gabeak2/RIAA_PREAMP/RIAA_preamp.kicad_pcb

## KiCad design RIAA_preamp.kicad_pcb (2025-05-13)

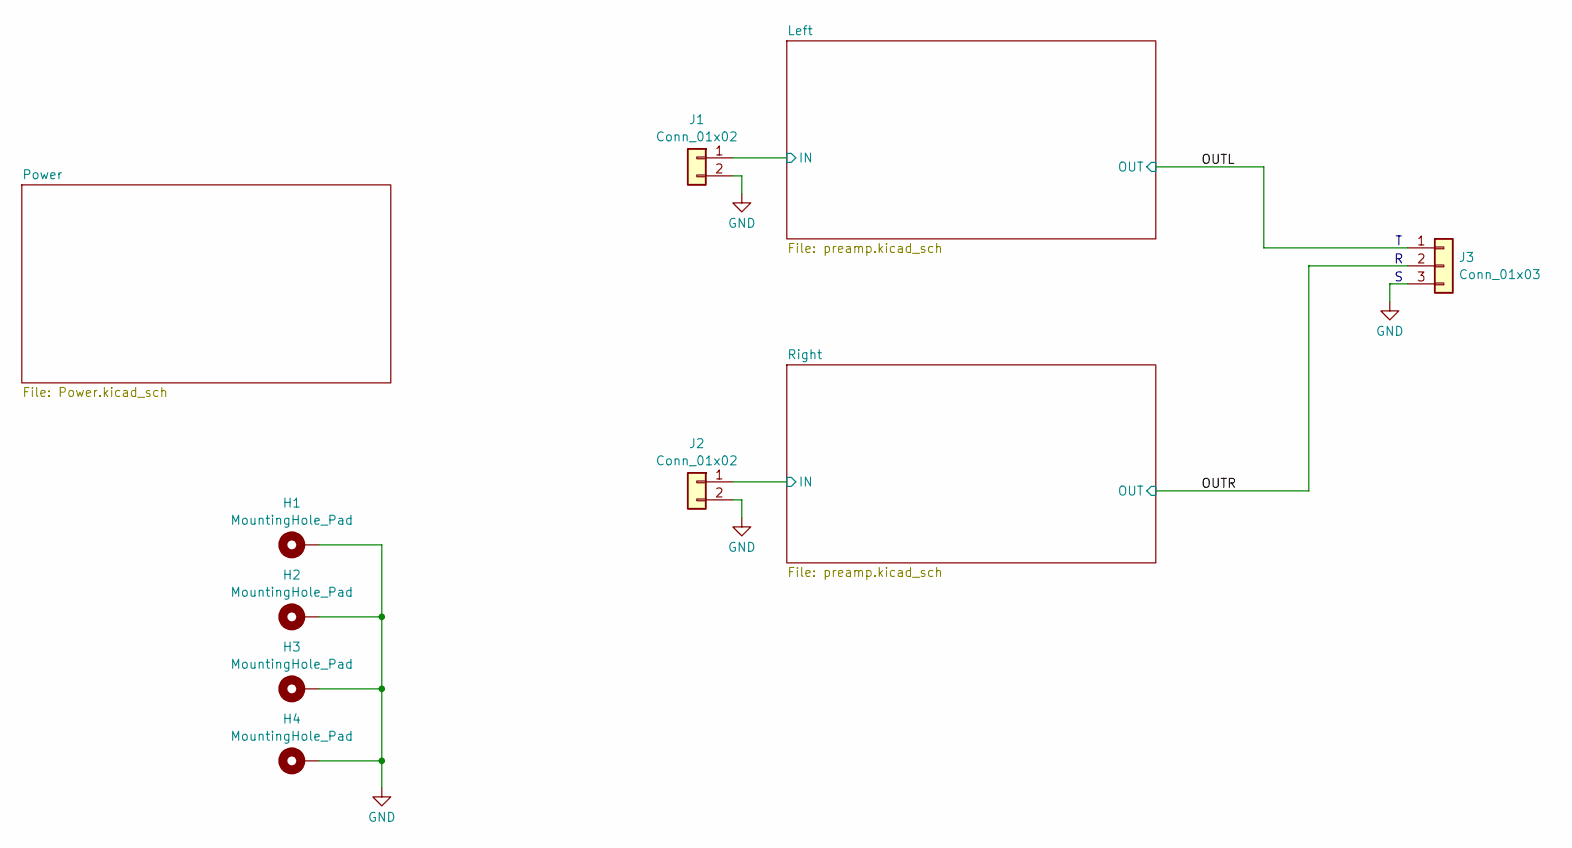
[picture p1: schematic RIAA_preamp.kicad_sch]

Parts:
H1, H2, H3, H4: MountingHole_Pad; MountingHole_3.2mm_M3_DIN965_Pad
J1, J2: Conn_01x02; PinHeader_1x02_P2.54mm_Vertical
J3: Conn_01x03; PinHeader_1x03_P2.54mm_Vertical

Connections:
/Left/IN: J1.1; also elsewhere on the board
/OUTL: J3.1; also elsewhere on the board
/OUTR: J3.2; also elsewhere on the board
/Right/IN: J2.1; also elsewhere on the board
GND: H1.1, H2.1, H3.1, H4.1, J1.2, J2.2, J3.3; also elsewhere on the board

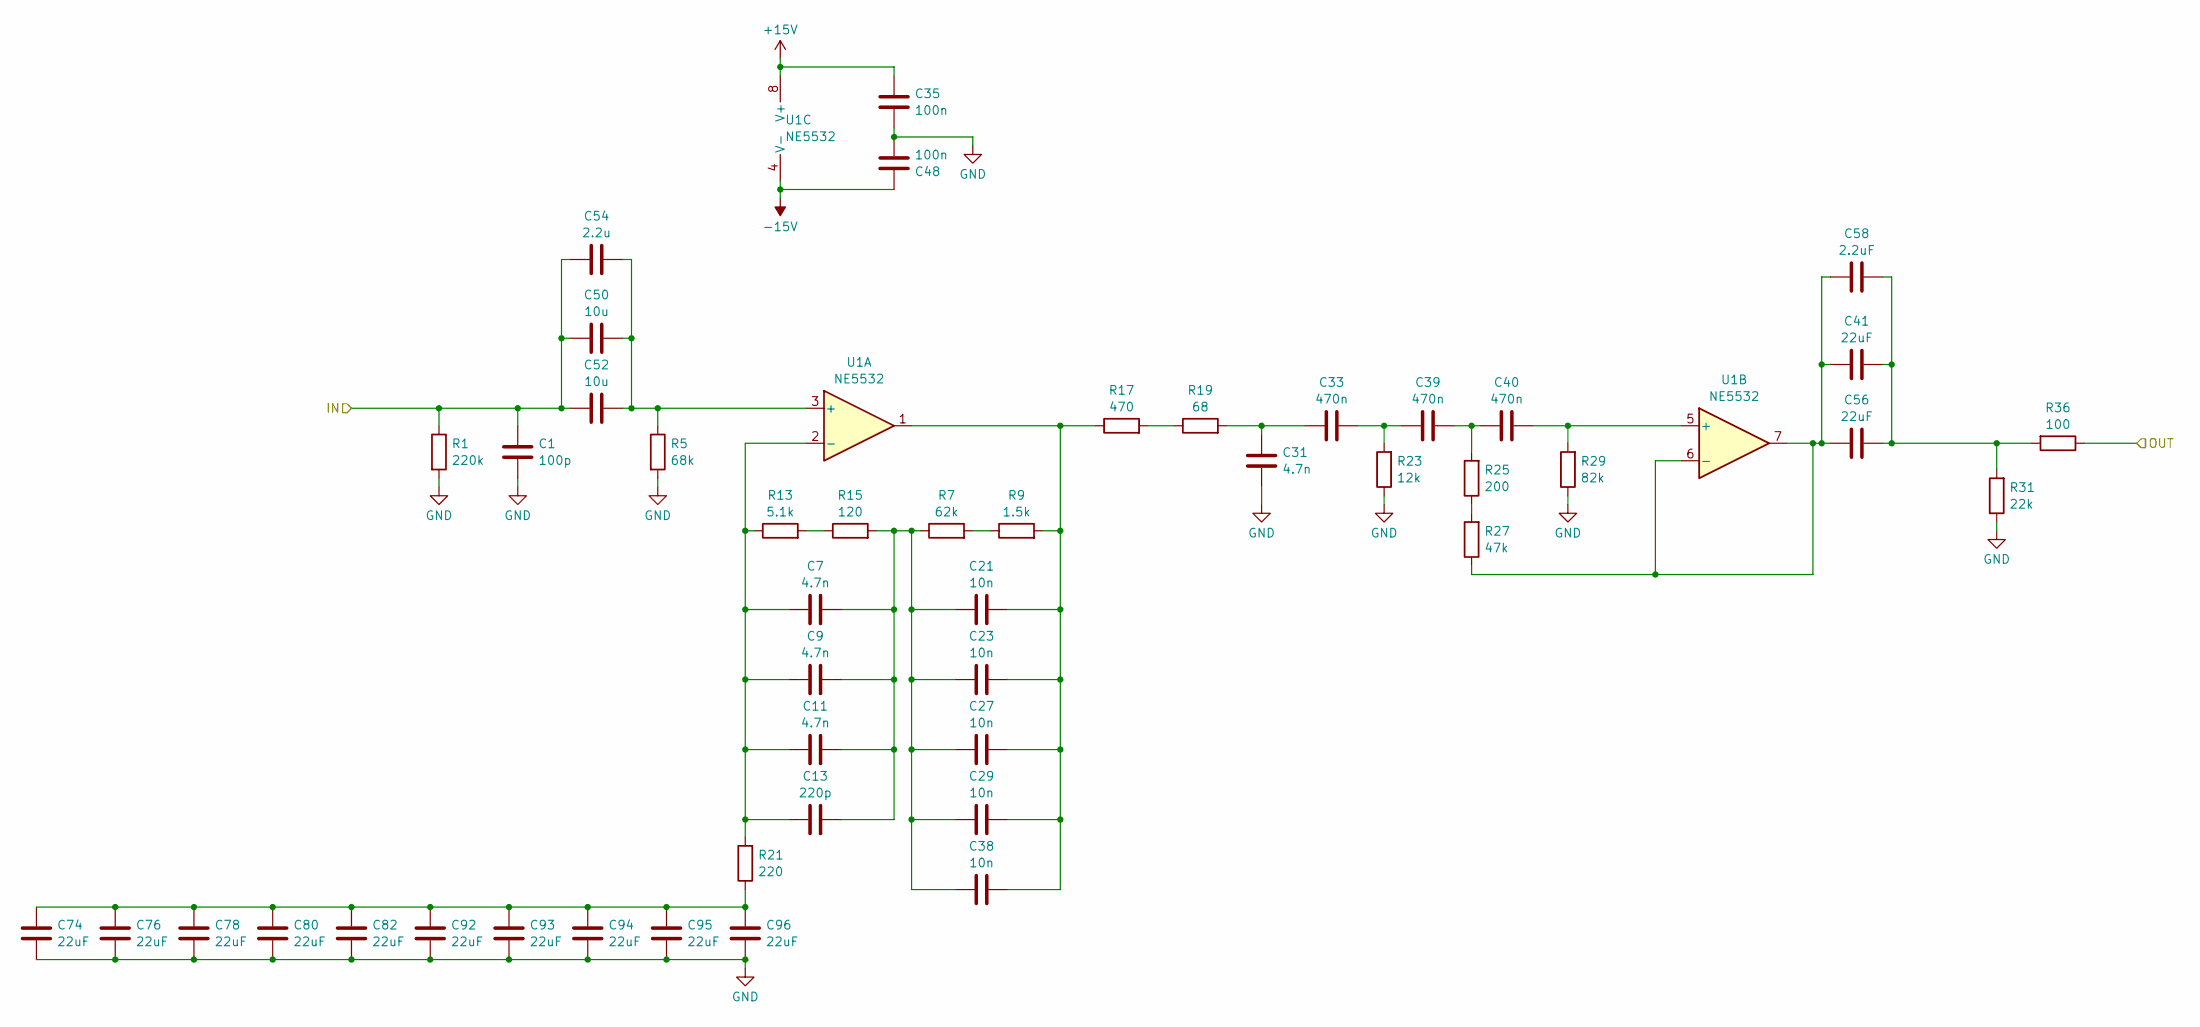
[picture p2: schematic preamp.kicad_sch]

Parts:
C1: 100p; C_0603_1608Metric; LCSC C55722
C7, C9, C11, C31: 4.7n; C_0603_1608Metric; LCSC C883564
C13: 220p; C_0603_1608Metric; LCSC C519500
C21, C23, C27, C29, C38: 10n; C_0805_2012Metric; LCSC C441760
C33, C39, C40: 470n; C_0805_2012Metric; LCSC C13967
C35, C48: 100n; C_0603_1608Metric; LCSC C14663
C41, C56: 22uF; C_0805_2012Metric; LCSC C45783
C50, C52: 10u; C_0805_2012Metric; LCSC C440198
C54: 2.2u; C_0805_2012Metric; LCSC C377773
C58: 2.2uF; C_0805_2012Metric; LCSC C377773
C74, C76, C78, C80, C82, C92, C93, C94, C95, C96: 22uF; C_0603_1608Metric; LCSC C59461
R1: 220k; R_0603_1608Metric; LCSC C22961
R5: 68k; R_0603_1608Metric; LCSC C23231
R7: 62k; R_0603_1608Metric; LCSC C23221
R9: 1.5k; R_0603_1608Metric; LCSC C22843
R13: 5.1k; R_0603_1608Metric; LCSC C23186
R15: 120; R_0603_1608Metric; LCSC C22787
R17: 470; R_0603_1608Metric; LCSC C23179
R19: 68; R_0603_1608Metric; LCSC C27592
R21: 220; R_0603_1608Metric; LCSC C22962
R23: 12k; R_0603_1608Metric; LCSC C22790
R25: 200; R_0603_1608Metric; LCSC C8218
R27: 47k; R_0603_1608Metric; LCSC C25819
R29: 82k; R_0603_1608Metric; LCSC C23254
R31: 22k; R_0603_1608Metric; LCSC C31850
R36: 100; R_0603_1608Metric; LCSC C22775
U1: NE5532; SOIC-8_3.9x4.9mm_P1.27mm; LCSC C7426

Connections:
+15V: C35.2, U1.8 (V+); also elsewhere on the board
-15V: C48.2, U1.4 (V-); also elsewhere on the board
/Left/IN: C1.1, C50.1, C52.1, C54.1, R1.1; also elsewhere on the board
/OUTL: R36.1; also elsewhere on the board
GND: C1.2, C31.1, C35.1, C48.1, C74.2, C76.2, C78.2, C80.2, C82.2, C92.2, C93.2, C94.2, C95.2, C96.2, R1.2, R5.2, R23.1, R29.1, R31.1; also elsewhere on the board
unnamed: C7.2, C9.2, C11.2, C13.2, C21.1, C23.1, C27.1, C29.1, C38.1, R7.1, R15.2
unnamed: C21.2, C23.2, C27.2, C29.2, C38.2, R9.2, R17.1, U1.1
unnamed: C31.2, C33.2, R19.2
unnamed: C33.1, C39.2, R23.2
unnamed: C39.1, C40.2, R25.2
unnamed: C41.1, C56.1, C58.1, R31.2, R36.2
unnamed: C74.1, C76.1, C78.1, C80.1, C82.1, C92.1, C93.1, C94.1, C95.1, C96.1, R21.1
unnamed: R7.2, R9.1
unnamed: R13.2, R15.1
unnamed: R17.2, R19.1
unnamed: R25.1, R27.2
unnamed: C50.2, C52.2, C54.2, R5.1, U1.3 (+)
unnamed: C7.1, C9.1, C11.1, C13.1, R13.1, R21.2, U1.2 (-)
unnamed: C40.1, R29.2, U1.5 (+)
unnamed: C41.2, C56.2, C58.2, R27.1, U1.6 (-), U1.7

Parts of its further copies:
C5: 100p; C_0603_1608Metric; LCSC C55722
C6, C8, C10, C22: 4.7n; C_0603_1608Metric; LCSC C883564
C12: 220p; C_0603_1608Metric; LCSC C519500
C17, C18, C19, C20, C36: 10n; C_0805_2012Metric; LCSC C441760
C24, C28, C30: 470n; C_0805_2012Metric; LCSC C13967
C32, C55: 22uF; C_0805_2012Metric; LCSC C45783
C34, C59: 100n; C_0603_1608Metric; LCSC C14663
C49, C51: 10u; C_0805_2012Metric; LCSC C440198
C53: 2.2u; C_0805_2012Metric; LCSC C377773
C57: 2.2uF; C_0805_2012Metric; LCSC C377773
C73, C75, C77, C79, C81, C87, C88, C89, C90, C91: 22uF; C_0603_1608Metric; LCSC C59461
R3: 220k; R_0603_1608Metric; LCSC C22961
R4: 68k; R_0603_1608Metric; LCSC C23231
R6: 62k; R_0603_1608Metric; LCSC C23221
R8: 1.5k; R_0603_1608Metric; LCSC C22843
R11: 5.1k; R_0603_1608Metric; LCSC C23186
R12: 120; R_0603_1608Metric; LCSC C22787
R14: 470; R_0603_1608Metric; LCSC C23179
R16: 68; R_0603_1608Metric; LCSC C27592
R18: 12k; R_0603_1608Metric; LCSC C22790
R20: 220; R_0603_1608Metric; LCSC C22962
R22: 200; R_0603_1608Metric; LCSC C8218
R24: 47k; R_0603_1608Metric; LCSC C25819
R26: 82k; R_0603_1608Metric; LCSC C23254
R28: 22k; R_0603_1608Metric; LCSC C31850
R30: 100; R_0603_1608Metric; LCSC C22775
U5: NE5532; SOIC-8_3.9x4.9mm_P1.27mm; LCSC C7426

Connections of its further copies:
+15V: C34.2, U5.8 (V+); also elsewhere on the board
-15V: C59.2, U5.4 (V-); also elsewhere on the board
/OUTR: R30.1; also elsewhere on the board
/Right/IN: C5.1, C49.1, C51.1, C53.1, R3.1; also elsewhere on the board
GND: C5.2, C22.1, C34.1, C59.1, C73.2, C75.2, C77.2, C79.2, C81.2, C87.2, C88.2, C89.2, C90.2, C91.2, R3.2, R4.2, R18.1, R26.1, R28.1; also elsewhere on the board
unnamed: C6.2, C8.2, C10.2, C12.2, C17.1, C18.1, C19.1, C20.1, C36.1, R6.1, R12.2
unnamed: C17.2, C18.2, C19.2, C20.2, C36.2, R8.2, R14.1, U5.1
unnamed: C22.2, C24.2, R16.2
unnamed: C24.1, C28.2, R18.2
unnamed: C28.1, C30.2, R22.2
unnamed: C32.1, C55.1, C57.1, R28.2, R30.2
unnamed: C73.1, C75.1, C77.1, C79.1, C81.1, C87.1, C88.1, C89.1, C90.1, C91.1, R20.1
unnamed: R6.2, R8.1
unnamed: R11.2, R12.1
unnamed: R14.2, R16.1
unnamed: R22.1, R24.2
unnamed: C49.2, C51.2, C53.2, R4.1, U5.3 (+)
unnamed: C6.1, C8.1, C10.1, C12.1, R11.1, R20.2, U5.2 (-)
unnamed: C30.1, R26.2, U5.5 (+)
unnamed: C32.2, C55.2, C57.2, R24.1, U5.6 (-), U5.7

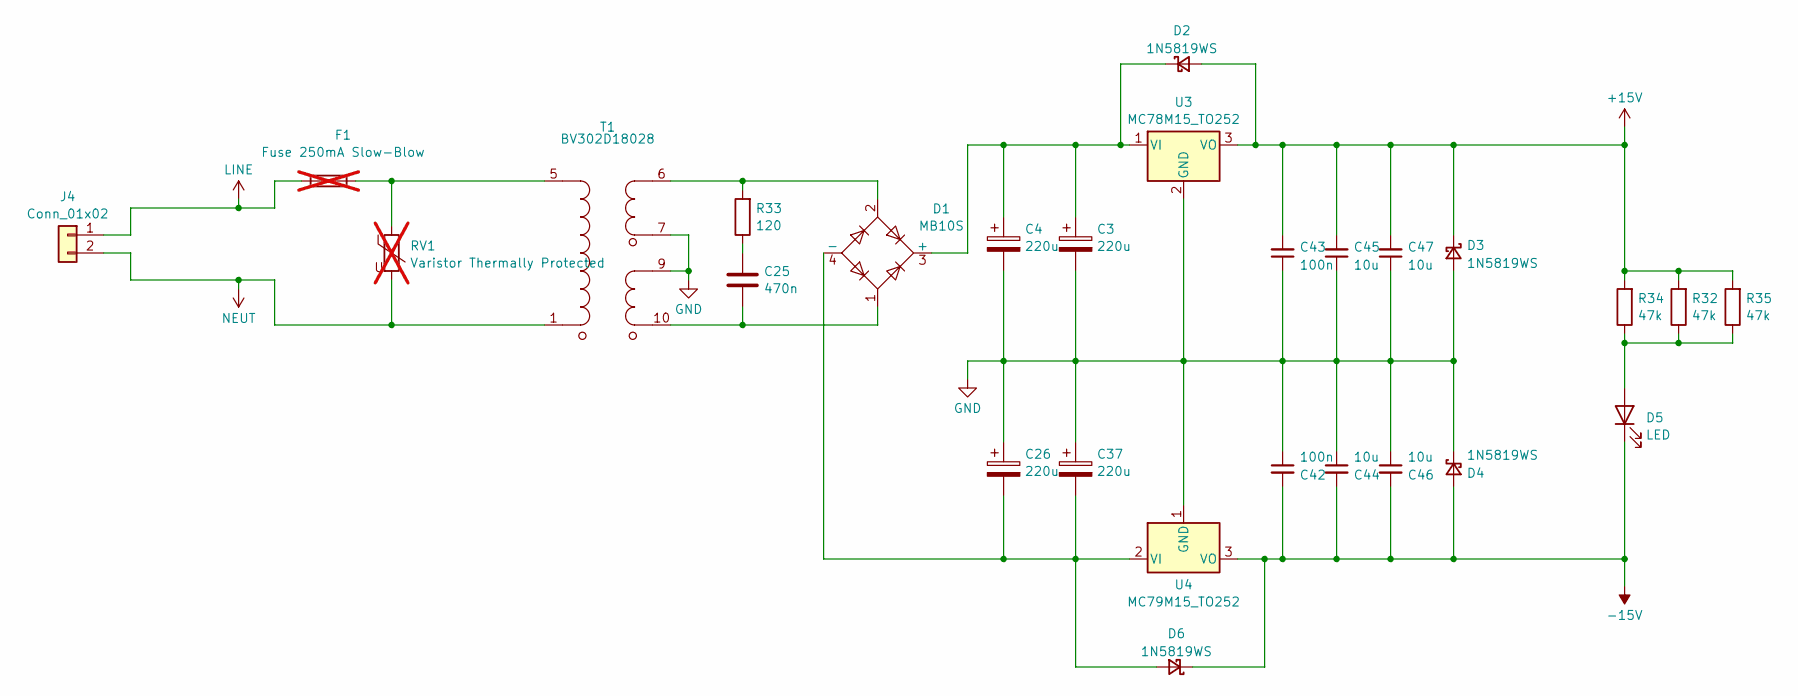
[picture p3: schematic Power.kicad_sch]

Parts:
C3, C4, C26, C37: 220u; CP_Elec_8x10.5; LCSC C2162304
C25: 470n; C_0805_2012Metric; LCSC C13967
C42, C43: 100n; C_0805_2012Metric; LCSC C14663
C44, C45, C46, C47: 10u; C_0805_2012Metric; LCSC C440198
D1: MB10S; TO-269AA; LCSC C2488
D2, D3, D4, D6: 1N5819WS; D_SOD-323; LCSC C191023
D5: LED; LED_D5.0mm
F1: Fuse 250mA Slow-Blow; Fuse_BelFuse_0ZRE0008FF_L8.3mm_W3.8mm; not fitted
J4: Conn_01x02; SolderWire-1sqmm_1x02_P5.4mm_D1.4mm_OD2.7mm_Relief
R32, R34, R35: 47k; R_0603_1608Metric; LCSC C25819
R33: 120; R_0603_1608Metric; LCSC C22787
RV1: Varistor Thermally Protected; RV_Disc_D12mm_W3.9mm_P7.5mm; not fitted
T1: BV302D18028
U3: MC78M15_TO252; TO-252-2; LCSC C95992
U4: MC79M15_TO252; TO-252-2; LCSC C19626424

Connections:
+15V: C43.2, C45.2, C47.2, D2.2 (A), D3.1 (K), R32.2, R34.2, R35.2, U3.3 (VO); also elsewhere on the board
-15V: C42.2, C44.2, C46.2, D4.2 (A), D5.1 (K), D6.1 (K), U4.3 (VO); also elsewhere on the board
GND: C3.2, C4.2, C26.1, C37.1, C42.1, C43.1, C44.1, C45.1, C46.1, C47.1, D3.2 (A), D4.1 (K), T1.7, T1.9, U3.2 (GND), U4.1 (GND); also elsewhere on the board
LINE: F1.1, J4.1
NEUT: J4.2, RV1.2, T1.1
unnamed: C25.1, R33.1
unnamed: C25.2, D1.1, T1.10
unnamed: C3.1, C4.1, D1.3 (+), D2.1 (K), U3.1 (VI)
unnamed: C26.2, C37.2, D1.4 (-), D6.2 (A), U4.2 (VI)
unnamed: D1.2, R33.2, T1.6
unnamed: D5.2 (A), R32.1, R34.1, R35.1
unnamed: F1.2, RV1.1, T1.5

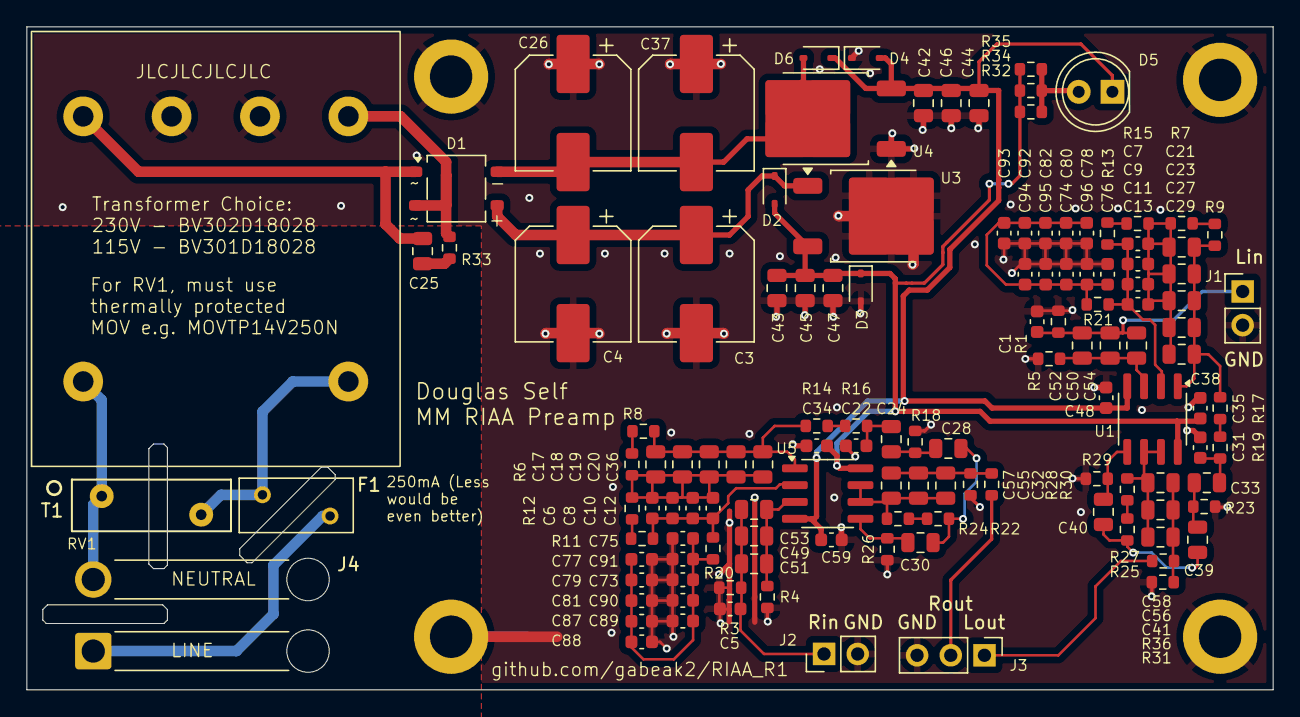
[picture p4: board RIAA_preamp.kicad_pcb from above]

Board: 2 copper layers, 94.0 x 50.0 mm, 130 parts (0 on the bottom side), 46 nets.
